garoa/garoa-candies/out/garoa_circulo_2048.png

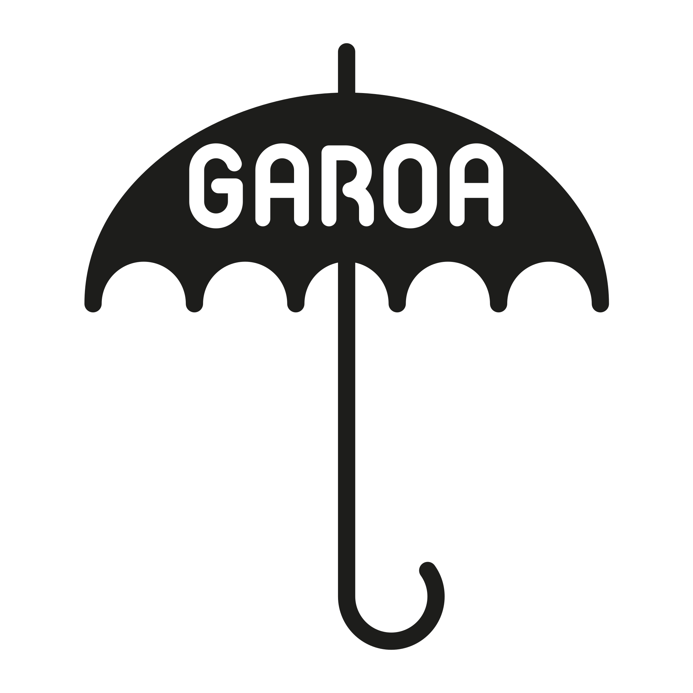
out/garoa_circulo_2048.png
