garoa/garoa-candies/out/guarda_chuva_abaulado_altura.png

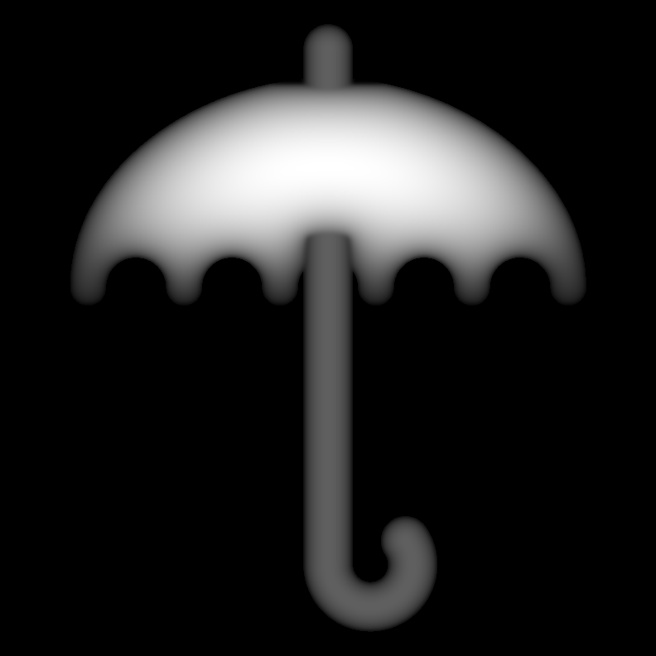
out/guarda_chuva_abaulado_altura.png
