garoa/garoa-candies/out/guarda_chuva_abaulado.stl

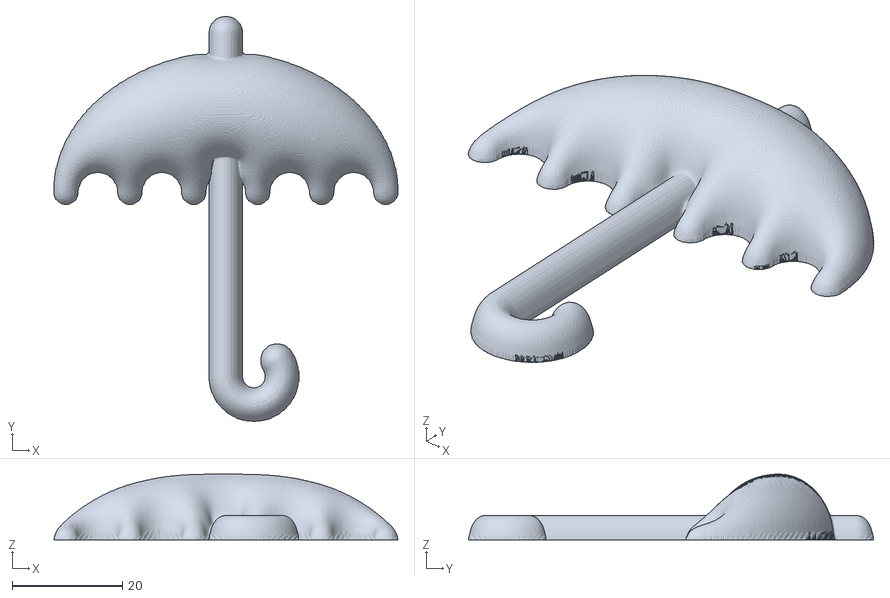
[picture p8: CAD file, 2026-10-29]
out/guarda_chuva_abaulado.stl
62.4 x 73.5 x 11.9
