garoa/garoa-candies/out/guarda_chuva_reto_arredondado.stl

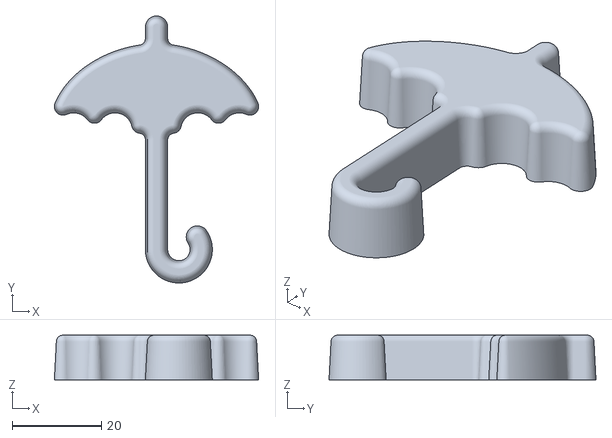
[picture p9: CAD file, 2026-10-29]
out/guarda_chuva_reto_arredondado.stl
45.8 x 59.8 x 10.0
