garoa/garoa-candies/out/quadrado_guarda_chuva.stl

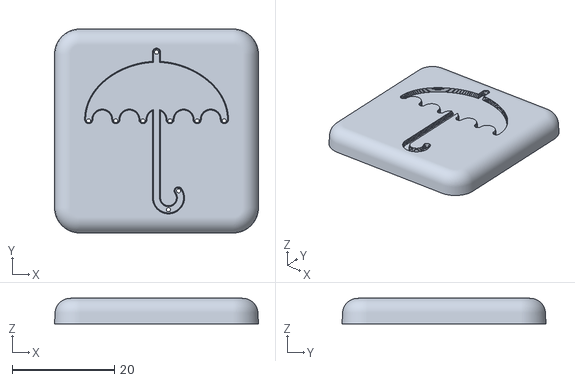
[picture p10: CAD file, 2026-10-29]
out/quadrado_guarda_chuva.stl
40.0 x 40.0 x 5.00
