garoa/garoa-candies/out/pao_de_mel_disco_logo.stl

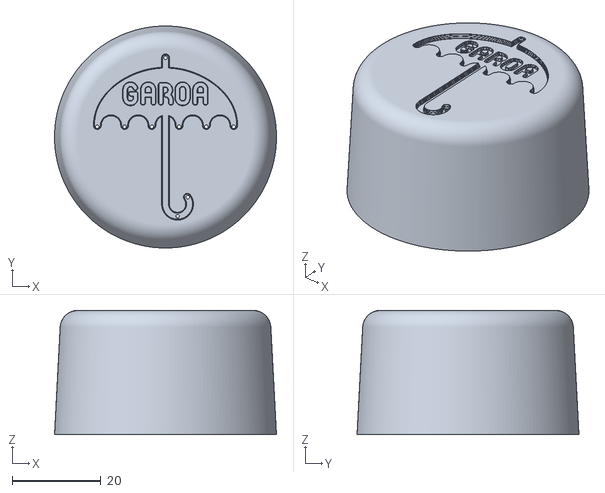
[picture p11: CAD file, 2026-10-29]
out/pao_de_mel_disco_logo.stl
50.0 x 50.0 x 28.0
