garoa/garoa-candies/out/guarda_chuva_extrudado_puro.stl

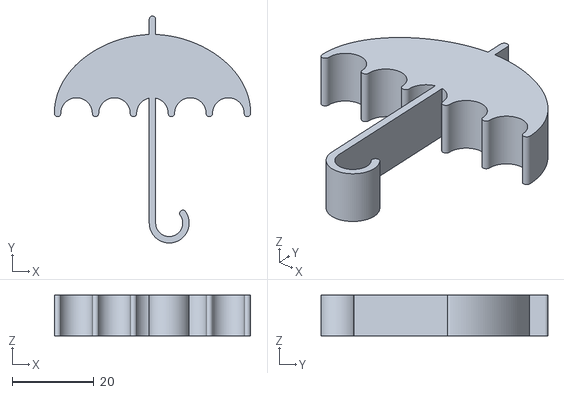
[picture p12: CAD file, 2026-10-29]
out/guarda_chuva_extrudado_puro.stl
48.0 x 55.5 x 10.0
