garoa/garoa-candies/out/guarda_chuva_abaulado_altura.scad

// gerado por guarda_chuva_abaulado_altura.py — não editar
MM_PX = 0.1;
ALTURA = 12.0;
PX = 792;
